Aperture-Shitpost-Innovators/ESPTempGauge/images/image.jpg

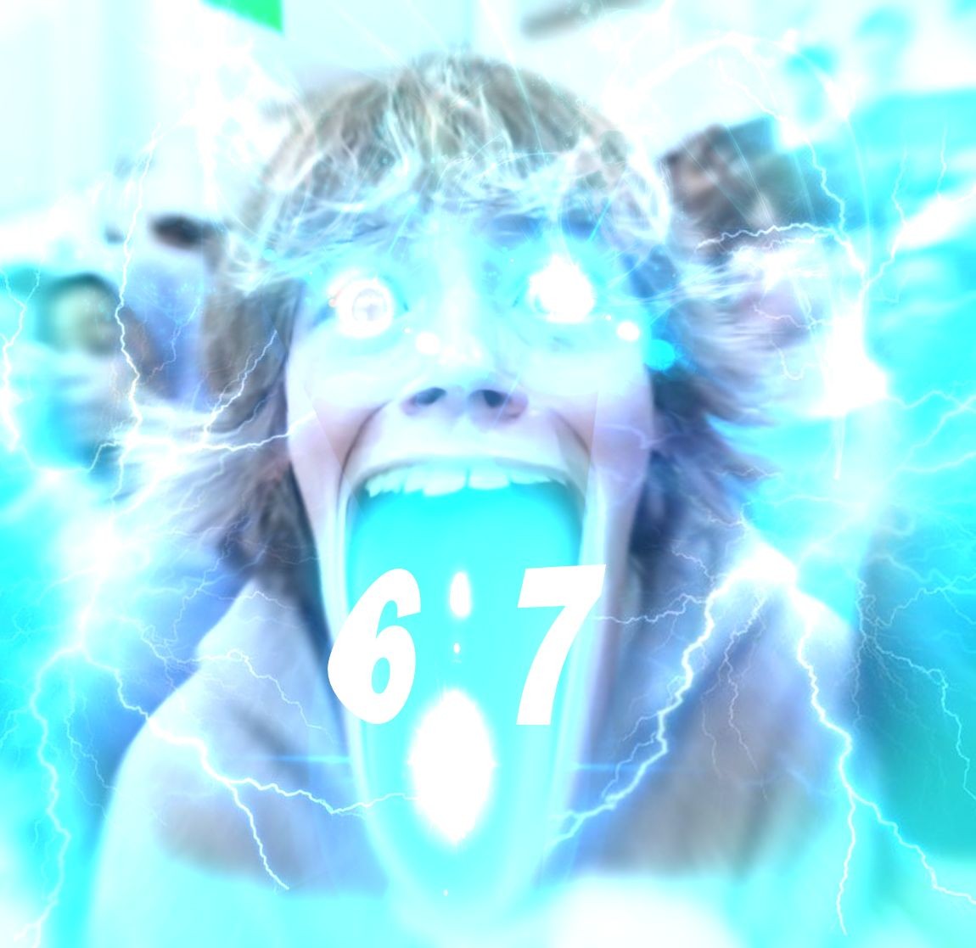
images/image.jpg
