Aperture-Shitpost-Innovators/ESPTempGauge/images/ordered_vs_made.jpg

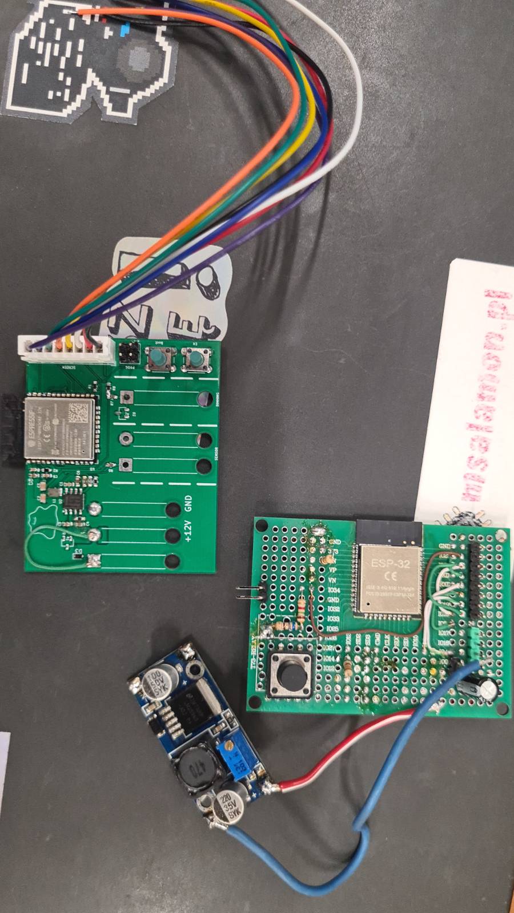
images/ordered_vs_made.jpg
