Aperture-Shitpost-Innovators/ESPTempGauge/hardware/ESP_Gauge.kicad_pcb

## KiCad design hardware/ESP_Gauge.kicad_pcb (2026-10-11)

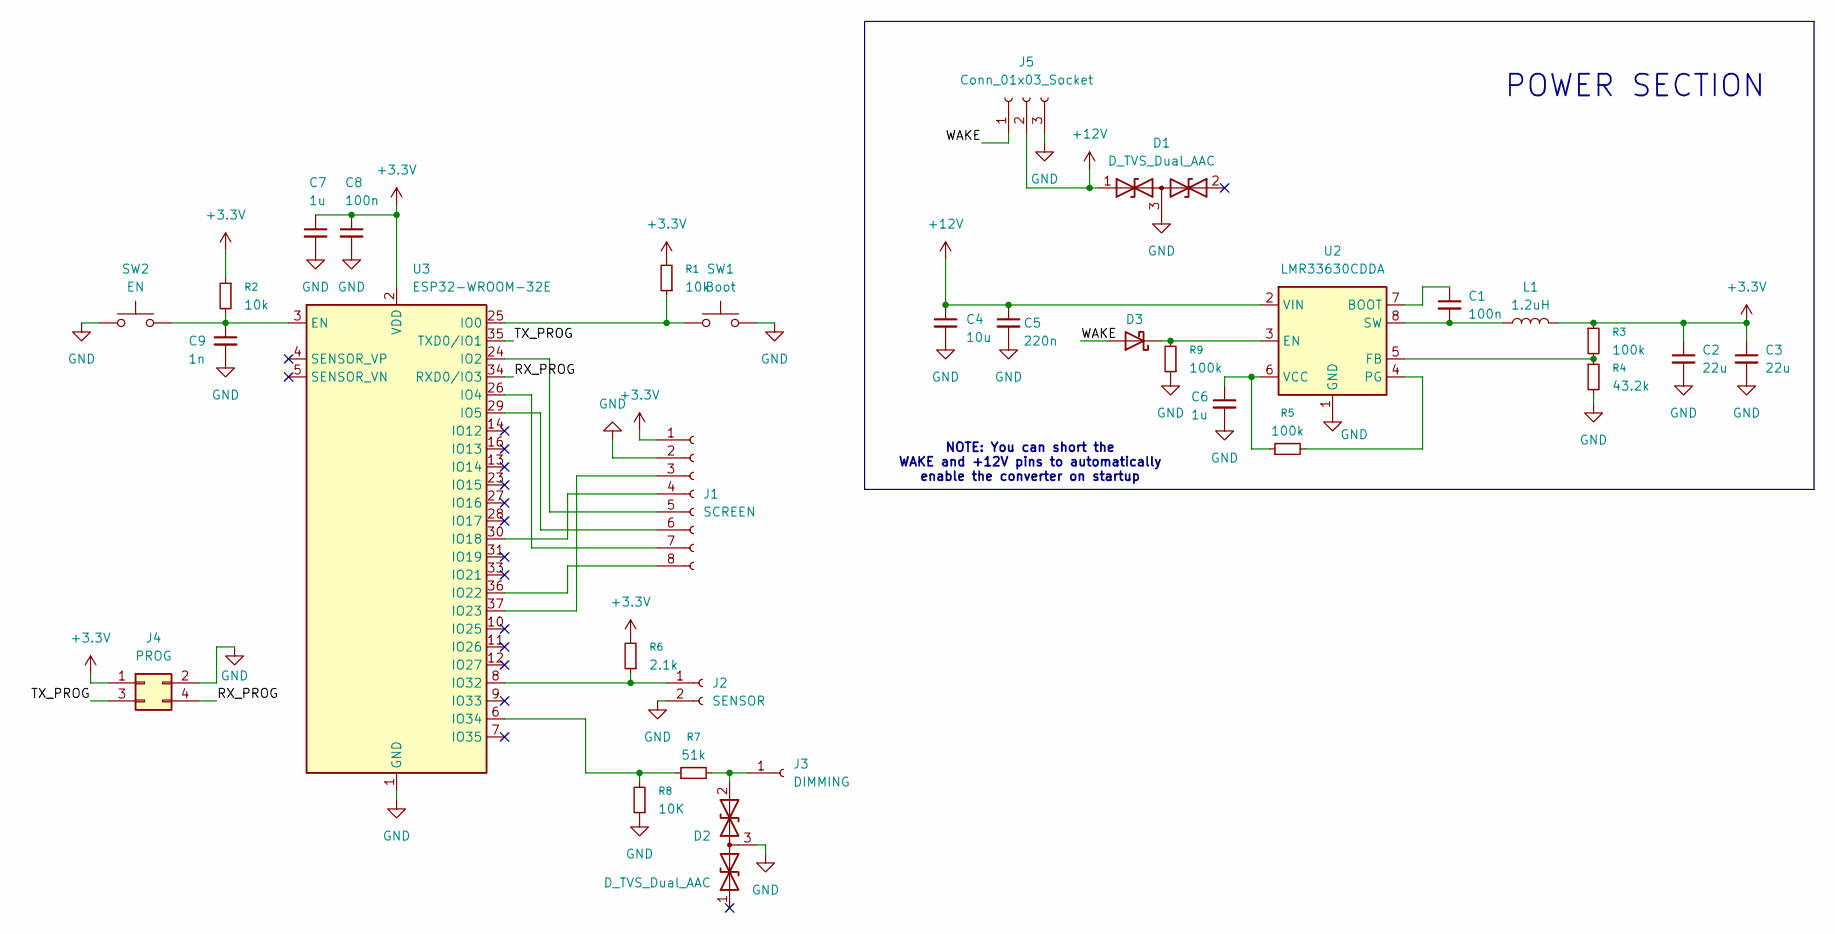
[picture p7: schematic ESP_Gauge.kicad_sch]

Parts:
C1, C8: 100n; C_0603_1608Metric_Pad1.08x0.95mm_HandSolder
C2, C3: 22u; C_0603_1608Metric_Pad1.08x0.95mm_HandSolder
C4: 10u; C_0603_1608Metric_Pad1.08x0.95mm_HandSolder
C5: 220n; C_0603_1608Metric_Pad1.08x0.95mm_HandSolder
C6, C7: 1u; C_0603_1608Metric_Pad1.08x0.95mm_HandSolder
C9: 1n; C_0603_1608Metric_Pad1.08x0.95mm_HandSolder
D1, D2: D_TVS_Dual_AAC; SOT-23-3
D3: D_Schottky; D_0603_1608Metric
J1: SCREEN; JST_XH_B8B-XH-AM_1x08_P2.50mm_Vertical
J2: SENSOR; SolderWire-0.75sqmm_1x02_P7mm_D1.25mm_OD3.5mm_Relief
J3: DIMMING; SolderWire-0.75sqmm_1x01_D1.25mm_OD3.5mm_Relief
J4: PROG; PinHeader_2x02_P2.54mm_Vertical
J5: Conn_01x03_Socket; SolderWire-0.75sqmm_1x03_P7mm_D1.25mm_OD3.5mm_Relief
L1: 1.2uH; L_1008_2520Metric_Pad1.43x2.20mm_HandSolder
R1, R2: 10k; R_0603_1608Metric_Pad0.98x0.95mm_HandSolder
R3, R5, R9: 100k; R_0603_1608Metric_Pad0.98x0.95mm_HandSolder
R4: 43.2k; R_0603_1608Metric_Pad0.98x0.95mm_HandSolder
R6: 2.1k; R_0603_1608Metric_Pad0.98x0.95mm_HandSolder
R7: 51k; R_0603_1608Metric_Pad0.98x0.95mm_HandSolder
R8: 10K; R_0603_1608Metric_Pad0.98x0.95mm_HandSolder
SW1: Boot; SW_PUSH_6mm_H5mm
SW2: EN; SW_PUSH_6mm_H5mm
U2: LMR33630CDDA; Texas_HSOP-8-1EP_3.9x4.9mm_P1.27mm_ThermalVias
U3: ESP32-WROOM-32E; ESP32-WROOM-32D

Connections:
+3.3V: C2.1, C3.1, C7.1, C8.1, J1.1, J4.1, L1.2, R1.2, R2.1, R3.1, R6.2, U3.2 (VDD)
+12V: C4.1, C5.1, D1.1 (A1), J5.2, U2.2 (VIN)
/RX_PROG: J4.4, U3.34 (RXD0/IO3)
/TX_PROG: J4.3, U3.35 (TXD0/IO1)
/WAKE: D3.2 (A), J5.1
GND: C2.2, C3.2, C4.2, C5.2, C6.2, C7.2, C8.2, C9.2, D1.3 (common), D2.3 (common), J1.2, J2.2, J4.2, J5.3, R4.2, R8.1, R9.1, SW1.2, SW2.2, U2.1 (GND), U2.9 (GND), U3.1 (GND), U3.15 (GND), U3.38 (GND), U3.39 (GND)
unnamed: D2.2 (A2), J3.1 (Pin_1_1), R7.2
unnamed: D3.1 (K), R9.2, U2.3 (EN)
unnamed: J1.3, U3.37 (IO23)
unnamed: J1.4, U3.30 (IO18)
unnamed: J1.5, U3.24 (IO2)
unnamed: J1.6, U3.29 (IO5)
unnamed: J1.7, U3.26 (IO4)
unnamed: J1.8, U3.36 (IO22)
unnamed: J2.1, R6.1, U3.8 (IO32)
unnamed: C1.1, U2.7 (BOOT)
unnamed: R3.2, R4.1, U2.5 (FB)
unnamed: R5.2, U2.4 (PG)
unnamed: C1.2, L1.1, U2.8 (SW)
unnamed: C6.1, R5.1, U2.6 (VCC)
unnamed: C9.1, R2.2, SW2.1, U3.3 (EN)
unnamed: R1.1, SW1.1, U3.25 (IO0)
unnamed: R7.1, R8.2, U3.6 (IO34)

Notes on the sheet:
NOTE: You can short the WAKE and +12V pins to automatically enable the converter on startup
POWER SECTION

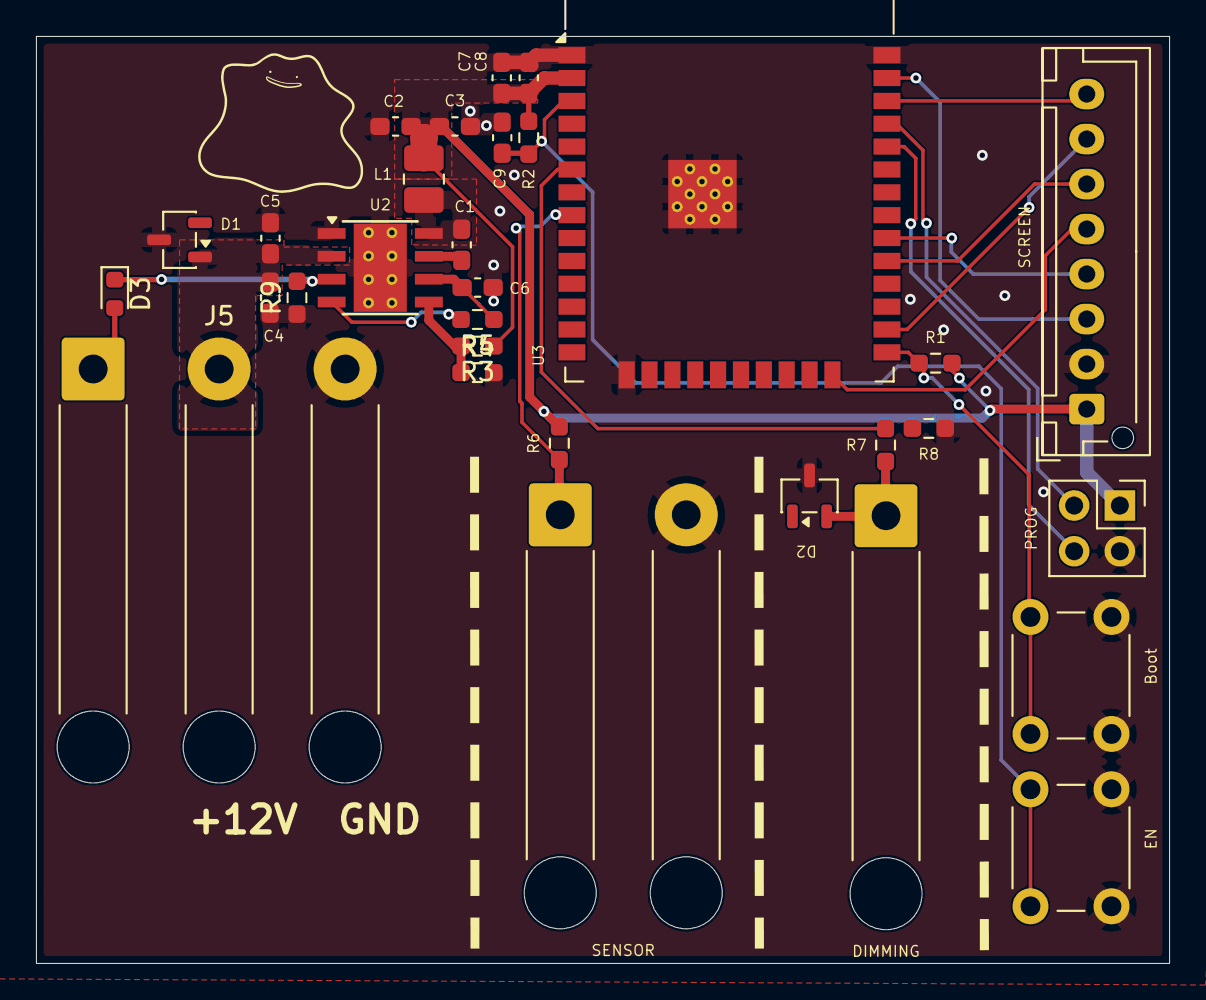
[picture p8: board ESP_Gauge.kicad_pcb from above]

Board: 2 copper layers, 63.0 x 51.5 mm, 31 parts (0 on the bottom side), 23 nets.
