Aperture-Shitpost-Innovators/ESPTempGauge/software/include/logo.h

#ifdef logoOnBoot
  // array size is 20636
  static const byte bootLogo[] PROGMEM  = {
    0x89, 0x50, 0x4e, 0x47, 0x0d, 0x0a, 0x1a, 0x0a, 0x00, 0x00, 0x00, 0x0d, 0x49, 0x48, 0x44, 0x52, 
    0x00, 0x00, 0x00, 0xf0, 0x00, 0x00, 0x00, 0xf0, 0x08, 0x06, 0x00, 0x00, 0x00, 0x3e, 0x55, 0xe9, 
    0x92, 0x00, 0x00, 0x20, 0x00, 0x49, 0x44, 0x41, 0x54, 0x78, 0x5e, 0xed, 0x7d, 0x09, 0x9c, 0x1c, 
    0x45, 0xf5, 0x7f, 0x57, 0xcf, 0xcc, 0x6e, 0x0e, 0x6e, 0x02, 0x01, 0x54, 0x08, 0x72, 0x88, 0xa0, 
    0x09, 0xb0, 0xbb, 0xb3, 0x39, 0xf6, 0x0c, 0xf7, 0xe1, 0x81, 0xbf, 0x5f, 0xa2, 0xbf, 0x9f, 0x17, 
    0x8a, 0x3f, 0x11, 0xff, 0x02, 0x22, 0x20, 0xc9, 0x1e, 0x71, 0xc8, 0x1e, 0x89, 0x80, 0xc8, 0xa1, 
    0x28, 0x78, 0xa1, 0xa8, 0x48, 0x82, 0xfa, 0x43, 0x05, 0x14, 0x30, 0x3b, 0xbb, 0x9b, 0x6b, 0x67, 
    0x36, 0x40, 0xf2, 0x13, 0x54, 0x40, 0x08, 0xa7, 0x84, 0xfb, 0x4a, 0xc8, 0x66, 0x76, 0xba, 0xfe, 
    0xdf, 0x9a, 0xdd, 0x99, 0x4c, 0x4f, 0x57, 0x77, 0x57, 0x77, 0x57, 0xf7, 0x1c, 0xbb, 0xed, 0xc7, 
    0x4f, 0x74, 0xa7, 0xea, 0xd5, 0xab, 0x57, 0xf5, 0xea, 0x78, 0xf5, 0xde, 0xf7, 0x11, 0x65, 0xf2, 
    0x2b, 0x2b, 0x09, 0xcc, 0xbb, 0x76, 0xd5, 0xd4, 0xd1, 0xd7, 0x0f, 0xfa, 0xa4, 0xa2, 0x69, 0x9f, 
    0x54, 0x14, 0xf5, 0x50, 0x30, 0xff, 0x5e, 0x45, 0xa1, 0x7b, 0xd9, 0x75, 0x22, 0xd9, 0xd3, 0x4c, 
    0x0a, 0xcb, 0xd4, 0x75, 0xf4, 0x27, 0x14, 0x4a, 0xa6, 0x2b, 0x44, 0x7b, 0x46, 0xa1, 0xca, 0xbd, 
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
    0xaa, 0xe4, 0x87, 0xc3, 0x5d, 0x4d, 0x17, 0x94, 0x8c, 0xe0, 0x4a, 0x9c, 0x91, 0x49, 0x05, 0x16, 
    0x18, 0xa0, 0x68, 0xfb, 0xe0, 0x4f, 0xa8, 0xa2, 0x7d, 0x51, 0xa0, 0x68, 0xc9, 0x16, 0xb1, 0x53, 
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
  };
#endif
