Aperture-Shitpost-Innovators/ESPTempGauge/(commit log)

2026-10-11 Added easily customizable wifi details, fixed compilation error when OTA updates were disabled
    [main.cpp]
2026-10-11 Added hardware schematics
    [ESP_Gauge.kicad_pcb, ESP_Gauge.kicad_sch]
2026-10-12 Tweaked calibration with a 6-point steinhart eq. Changed picture for a prettier one
